QuincyTN/Masimo-Cable-Tester/docs/board_layout.png

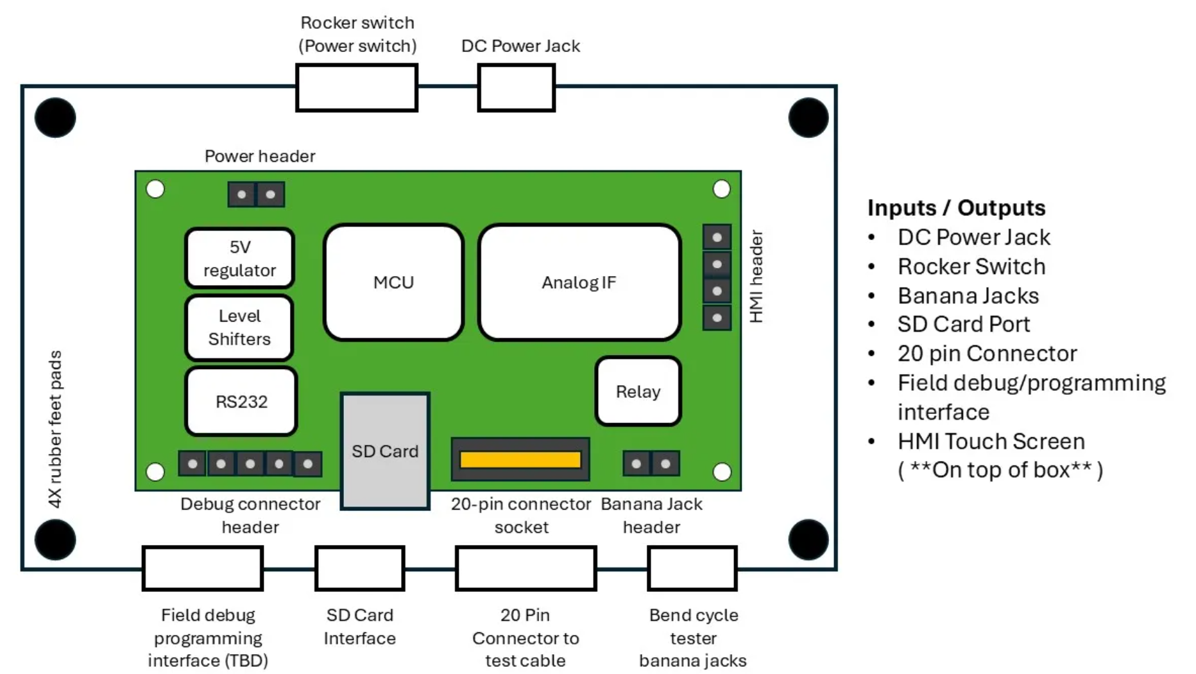
docs/board_layout.png
