QuincyTN/Masimo-Cable-Tester/docs/rough_PCB_layout.JPG

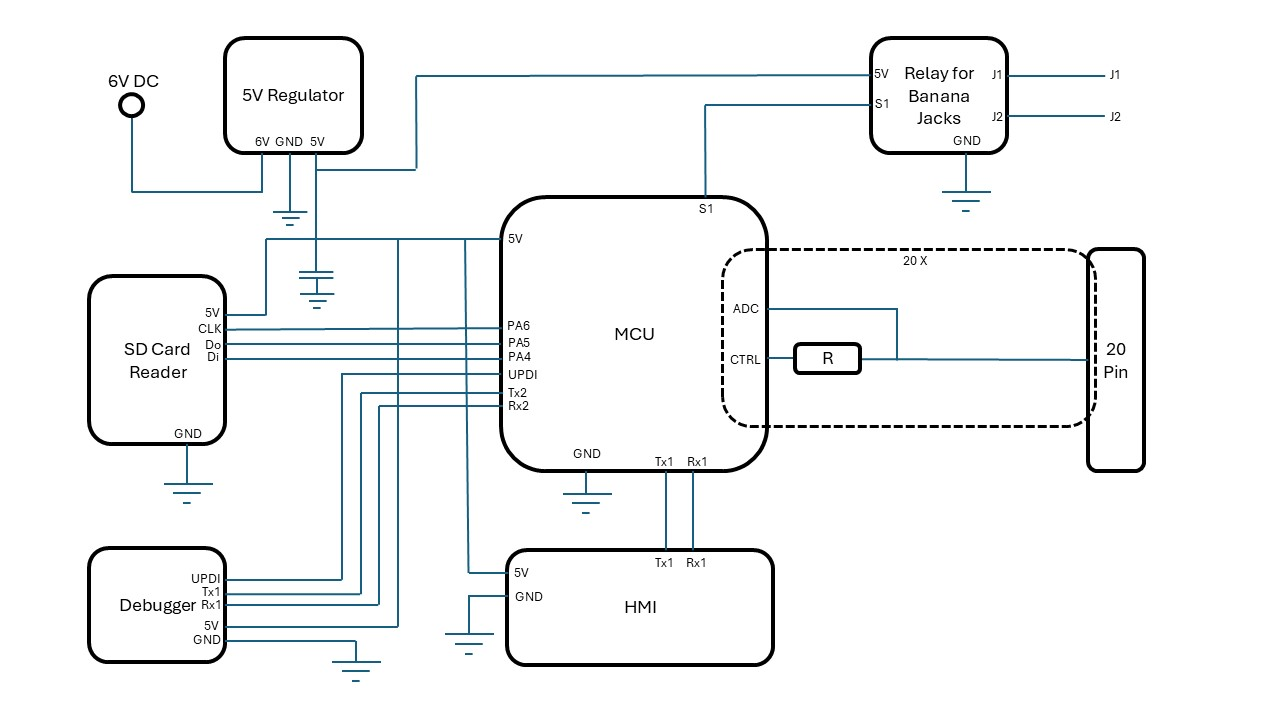
docs/rough_PCB_layout.JPG
