QuincyTN/Masimo-Cable-Tester/prototyping/Masimo_cable_tester_1/KiCad Symbols and Footprints/54-00129.step

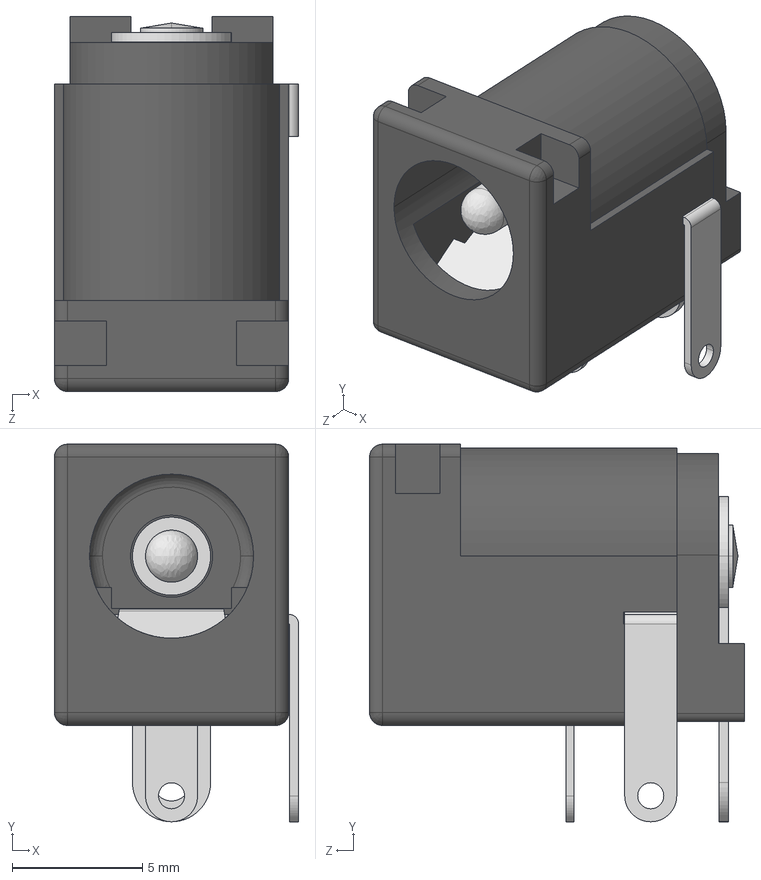
[picture p14: CAD file, 2025-02-21]
prototyping/Masimo_cable_tester_1/KiCad Symbols and Footprints/54-00129.step
9.38 x 14.5 x 14.4 mm
54-00129STP2141.STEP
54-00129STP2142.STEP
54-00129STP2143.STEP
54-00129STP2144.STEP
54-00129STP2145.STEP
54-00129STP2146.STEP
