QuincyTN/Masimo-Cable-Tester/prototyping/Masimo_cable_tester_1/KiCad Symbols and Footprints/SFML-110-02-L-D-A.step

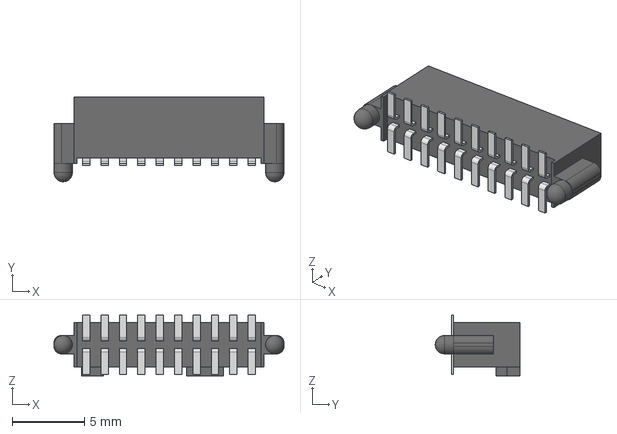
[picture p15: CAD file, 2025-02-18]
prototyping/Masimo_cable_tester_1/KiCad Symbols and Footprints/SFML-110-02-L-D-A.step
15.9 x 5.84 x 4.20 mm
SFML-110-02-L-D-A_terminal
C-10-02-D-L_pins
