QuincyTN/Masimo-Cable-Tester/prototyping/Masimo_cable_tester_1/Masimo_cable_tester_1.kicad_pcb

## KiCad design prototyping/Masimo_cable_tester_1/Masimo_cable_tester_1.kicad_pcb (2025-02-21)

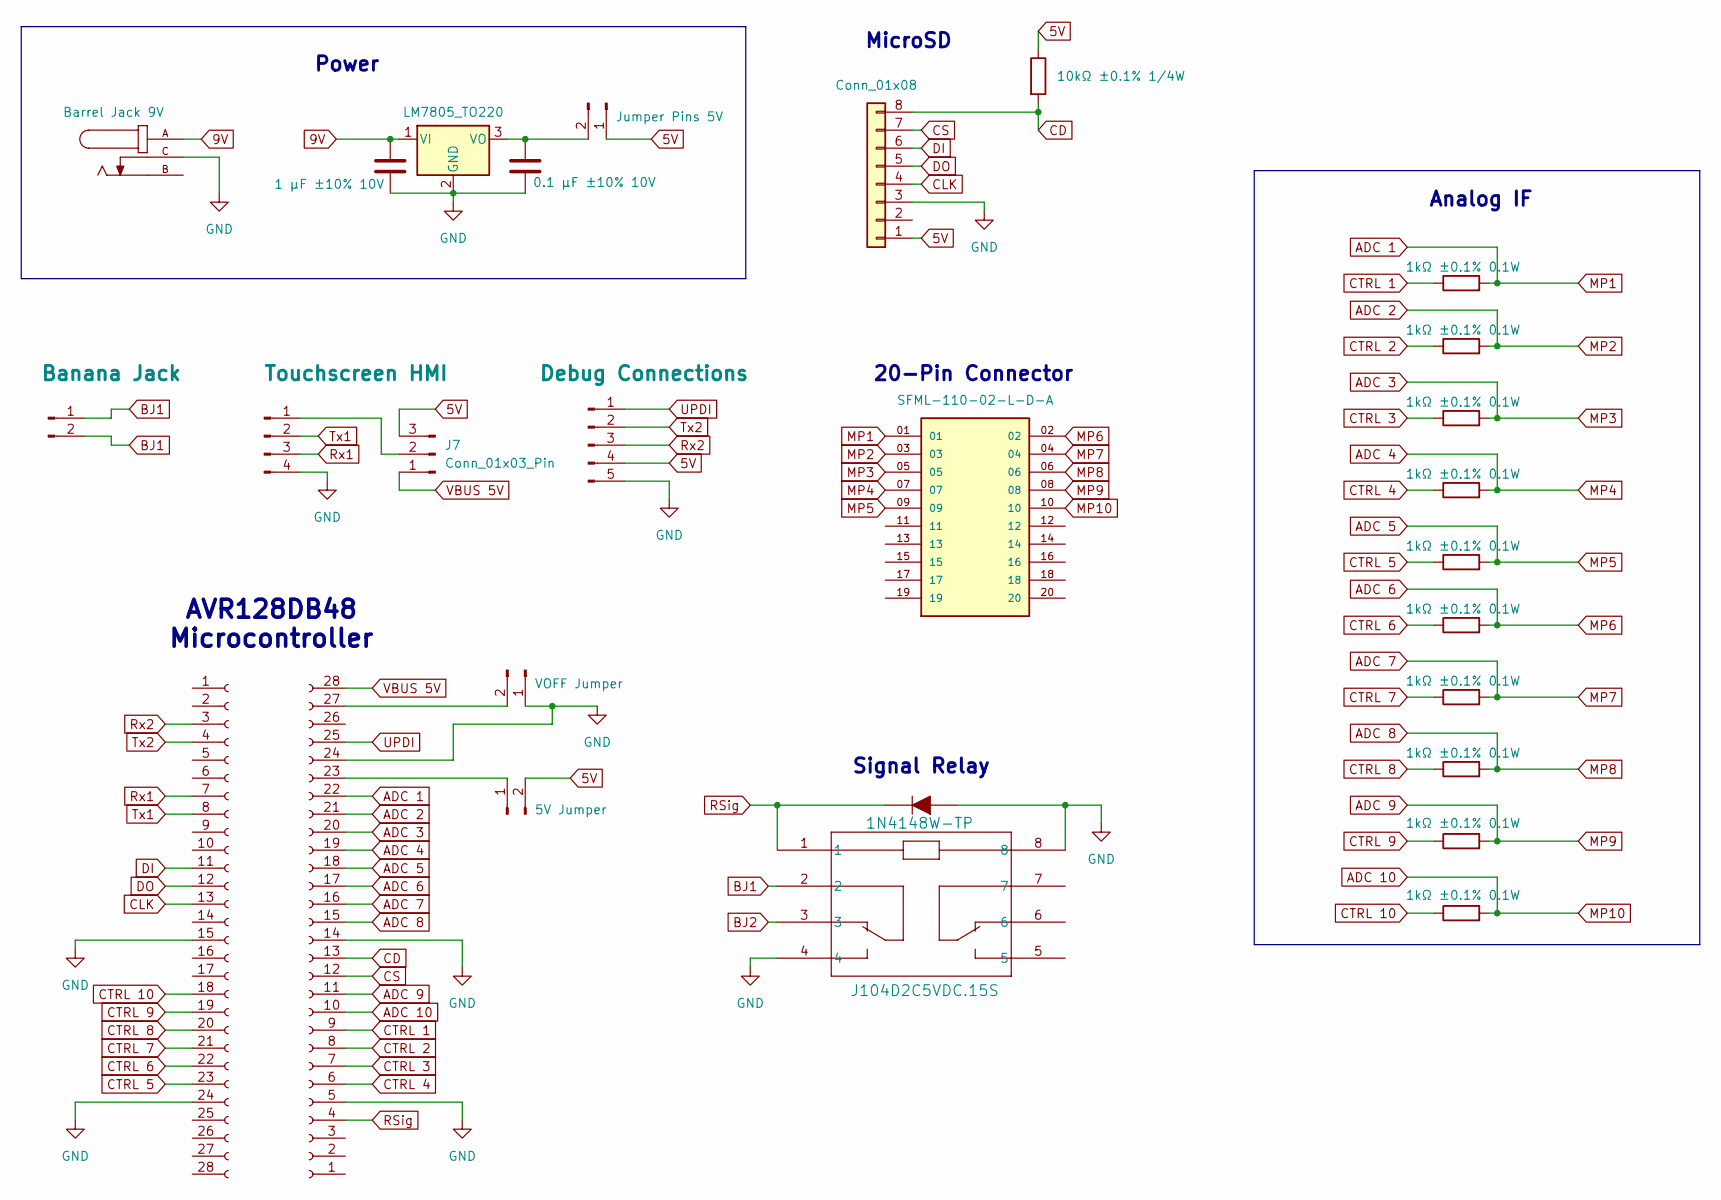
[picture p16: schematic Masimo_cable_tester_1.kicad_sch, Automated multiconductor cable break-short detector]

Parts:
C1: 1 µF ±10% 10V; CAP_CL10_SAM
C2: 0.1 µF ±10% 10V; CAP_CL05_SAM
D2: 1N4148W-TP; SOD-123; MPN 1N4148W-TP; Digi-Key_PN 1N4148WTPMSCT-ND
J1: Touchscreen HMI; PinHeader_1x04_P2.54mm_Vertical
J2, J3: Conn_01x28_Socket; PinHeader_1x28_P2.54mm_Vertical
J4: Barrel Jack 9V; TENSILITY_54-00129; PARTREV A
J5: Conn_01x08; PinHeader_1x08_P2.54mm_Vertical
J6: SFML-110-02-L-D-A; SAMTEC_SFML-110-02-L-D-A; PARTREV E
J7: Conn_01x03_Pin; PinHeader_1x03_P2.54mm_Vertical
J8: Jumper Pins 5V; PinHeader_1x02_P2.54mm_Vertical
J9: VOFF Jumper; PinHeader_1x02_P2.54mm_Vertical
J10: 5V Jumper; PinHeader_1x02_P2.54mm_Vertical
J16: Debug Connections; PinHeader_1x05_P2.54mm_Vertical
J17: Banana Jack; PinHeader_1x02_P2.54mm_Vertical
R1: 10kΩ ±0.1% 1/4W; RC0402N_PAN
R3, R4, R5, R6, R7, R8, R9, R10, R11, R12: 1kΩ ±0.1% 0.1W; RES_0816_SUS
U1: J104D2C5VDC.15S; RELAY8_J104D2C5VDC.20S_CRS
U2: LM7805_TO220; TO-220-3_Vertical

Connections:
5V: J5.1, J7.3, J8.1, J10.2, J16.4, R1.1
9V: C1.1, J4.A, U2.1 (VI)
ADC 1: J3.22, J6.01, R3.2
ADC 2: J3.21, J6.03, R4.2
ADC 3: J3.20, J6.05, R5.2
ADC 4: J3.19, J6.07, R6.2
ADC 5: J3.18, J6.09, R7.2
ADC 6: J3.17, J6.02, R8.2
ADC 7: J3.16, J6.04, R9.2
ADC 8: J3.15, J6.06, R10.2
ADC 9: J3.11, J6.08, R11.2
ADC 10: J3.10, J6.10, R12.2
BJ1: J17.1, J17.2, U1.2
BJ2: U1.3
CD: J3.13, J5.8, R1.2
CLK: J2.13, J5.4
CS: J3.12, J5.7
CTRL 1: J3.9, R3.1
CTRL 2: J3.8, R4.1
CTRL 3: J3.7, R5.1
CTRL 4: J3.6, R6.1
CTRL 5: J2.23, R7.1
CTRL 6: J2.22, R8.1
CTRL 7: J2.21, R9.1
CTRL 8: J2.20, R10.1
CTRL 9: J2.19, R11.1
CTRL 10: J2.18, R12.1
DI: J2.11, J5.6
DO: J2.12, J5.5
GND: C1.2, C2.2, D2.A, J1.4, J2.15, J2.24, J3.5, J3.14, J3.24, J4.C, J5.3, J9.1, J16.5, U1.4, U1.8, U2.2 (GND)
unnamed: J1.1, J7.2
unnamed: J3.27, J9.2
unnamed: C2.1, J8.2, U2.3 (VO)
unnamed: J3.23, J10.1
RSig: D2.K, J3.4, U1.1
Rx1: J1.3, J2.7
Rx2: J2.3, J16.3
Tx1: J1.2, J2.8
Tx2: J2.4, J16.2
UPDI: J3.25, J16.1
VBUS 5V: J3.28, J7.1

Notes on the sheet:
Signal Relay
MicroSD
20-Pin Connector
Power
AVR128DB48 Microcontroller
Analog IF

Board: 2 copper layers, 28 parts (0 on the bottom side), 40 nets, no tracks yet.
