QuincyTN/Masimo-Cable-Tester/(commit log)

2024-10-14 add system description document
    The System Description document describes major details of how the device operates, what it is capable of, and the different components used to build it
2024-10-14 add board layout image
    image of how the PCB of the device will be structured. This is the first iteration as the design may change
2024-10-18 add rough PCB layout
    PCB layout of the Cable Tester. The SD card reader will need a level shifter in the future
2024-10-22 blinking LED on MCU
    Create a blinking LED on MCU with 2s period. PORTx.DIRSET is used to set the pin direction. PORTx.OUT is used to set the output pin value. Purpose is to familiarize with the AVR128DB48 pins
2024-10-26 create test for HMI
    testing buttons and uploading code to HMI.
2024-11-01 attempt to send data to HMI
    set up HMI screen (Just a text box). In microchip studio, try to set up USART. there should be a counter displayed on the HMI, but nothing is being sent. some problems may be the incorrect (overflow or wrong val) BAUDRATE, using the wrong ports, connecting to the wrong ports
    [main.c]
2024-11-07 implement USART with interrupts
    interrupt will start after the transmit() function
2024-11-15 Attempt send data from HMI to MCU
    It does not work. The receive buffer does not fill up? Tried to implement receiver without the interrupt using receiver3() which reads 1 char. After pressing the HMI button, it does not read.
    [main.c]
2024-11-19 finish USART transmitter and receiver
    HMI can receive and send data. Discard the transmitter ISR, and do all the transmission inside the transmitX() function. On boot up, the transmitter/receiver doesn't work, but functions normally after 5-10 seconds.
    [main.c]
2024-11-23 Upload Version 1 Schematic
    [Masimo_cable_tester_1.kicad_pcb, Masimo_cable_tester_1.kicad_sch]
2025-02-05 Test the get command from the MCU to the HMI
    get number and text values from the HMI and display them on the terminal. Set up a timer and interrupt, which every 1 second will get values from the HMI.
2025-02-06 Updated the Prototyping PCB schematic
    Changed the signal relay symbol and footprint to the correct one. Added a flyback diode to the relay. Added the power required for each resistor. And various general updates to tags and connections.
    [Masimo_cable_tester_1.kicad_pcb, Masimo_cable_tester_1.kicad_sch]
2025-02-06 Files for the Relay
    I added the files for the KiCad symbol and footprint for the signal relay
2025-02-06 Attaching footprints to MCU connector and SD card reader
    [Masimo_cable_tester_1.kicad_sch]
2025-02-06 Added jumpers
    [Masimo_cable_tester_1.kicad_sch]
2025-02-14 Fixing Error and More
    Fixed error where string would not display correctly on terminal. Also, information displayed on terminal was made nicer for viewing purposes. Worked on these things with Quincy.
    [main.c]
2025-02-16 Fix Terminal Bug
    Fixed bug where terminal input disabled transmitTerminal(). Added addition functions to test
    [main.c]
2025-02-18 Prototype schematic updates
    [Masimo_cable_tester_1.kicad_sch, SFML-110-02-L-D-A.step]
2025-02-18 Added resistors footprint.
    [Masimo_cable_tester_1.kicad_sch]
2025-02-18 Prototype board updates
    Added new components with footprints
    [Masimo_cable_tester_1.kicad_sch]
2025-02-18 Added capacitor footprints.
    [Masimo_cable_tester_1.kicad_sch]
2025-02-21 Prototype PCB updates and additions
    Consolidated the KiCad symbols and footprints used into a single folder to be used. Updated jumper footprints and started to organize the PCB components. (no traces yet).
    [54-00129.step, Masimo_cable_tester_1.kicad_pcb, Masimo_cable_tester_1.kicad_sch, SFML-110-02-L-D-A.step]
2025-02-24 SD/MCU/GUI communication
    Successfully able to change a checkbox from true to false or vice versa based on if the SD card is inserted or not
2025-02-27 testing stuff
    testing sd card capacity
