QuincyTN/Masimo-Cable-Tester/(notices)

Notices in the files:
prototyping/SD Card AVR DB/AVR_sd.c:
This program is free software: you can redistribute it and/or modify
it under the terms of the GNU General Public License as published by
the Free Software Foundation, either version 3 of the License, or
(at your option) any later version.
prototyping/Masimo_cable_tester_1/KiCad Symbols and Footprints/SFML-110-02-L-D-A.step:
author */ ('License CC BY-ND 4.0'),
